bravod59487/EPF/Arduino/WifiCaptivePage.h

#ifndef WifiCaptivePage_h
#define WifiCaptivePage_h

#include <pgmspace.h>

const uint8_t INDEX_HTML[] PROGMEM = { 0x1f, 0x8b, 0x8, 0x0, 0x2b, 0xa8, 0x15, 0x6a, 0x2, 0xff, 0xdd, 0x3c, 0x6b, 0x73, 0xdb, 0x46, 0x92, 0xdf, 0xf3, 0x2b, 0x26, 0xf4, 0x26, 0x20, 0xf7, 0x4, 0x8, 0x6f, 0x82, 0xb4, 0xa4, 0x8d, 0xa2, 0x38, 0xb7, 0xbe, 0x8a, 0x13, 0x57, 0xe4, 0xdb, 0x54, 0xea, 0xea, 0x2a, 0x1, 0x81, 0xa1, 0x88, 0x35, 0x8, 0x30, 0x0, 0x28, 0x4a, 0xf6, 0xfa, 0xbf, 0x5f, 0xf7, 0xcc, 0x0, 0x98, 0x1, 0x1, 0x88, 0xce, 0x25, 0x55, 0xbe, 0xb3, 0x45, 0x8, 0x18, 0xf4, 0xf4, 0xf4, 0xbb, 0x7b, 0x1e, 0xd4, 0xc5, 0xe7, 0xdf, 0xfc, 0x70, 0xf3, 0xe6, 0xe7, 0xd7, 0x2f, 0xc8, 0xa6, 0xda, 0xa6, 0x57, 0x9f, 0x5d, 0xf0, 0x5f, 0xf0, 0x9b, 0x86, 0xf1, 0xd5, 0x67, 0x84, 0x5c, 0x6c, 0x69, 0x15, 0x92, 0x2c, 0xdc, 0xd2, 0xcb, 0xc9, 0x7d, 0x42, 0xf, 0xbb, 0xbc, 0xa8, 0x26, 0x24, 0xca, 0xb3, 0x8a, 0x66, 0xd5, 0xe5, 0xe4, 0x90, 0xc4, 0xd5, 0xe6, 0x32, 0xa6, 0xf7, 0x49, 0x44, 0x75, 0xf6, 0x70, 0x46, 0x92, 0x2c, 0xa9, 0x92, 0x30, 0xd5, 0xcb, 0x28, 0x4c, 0xe9, 0xa5, 0x35, 0x61, 0x68, 0xaa, 0xa4, 0x4a, 0xe9, 0xd5, 0xb, 0x7d, 0x17, 0xee, 0x68, 0x41, 0x5e, 0x6f, 0xf2, 0x2a, 0x27, 0xdf, 0x16, 0x80, 0x96, 0xfc, 0x94, 0xe8, 0xdf, 0x26, 0xe4, 0x26, 0xcf, 0xd6, 0xc9, 0xdd, 0xbe, 0x8, 0xab, 0x24, 0xcf, 0x2e, 0xce, 0x39, 0x38, 0x76, 0x2c, 0xab, 0x47, 0x7e, 0x47, 0x48, 0x15, 0xae, 0x52, 0x4a, 0xde, 0xb3, 0x7b, 0x42, 0x56, 0x79, 0x11, 0xd3, 0x42, 0x2f, 0x77, 0x61, 0x94, 0x64, 0x77, 0x4b, 0x62, 0x3d, 0x57, 0x5f, 0x44, 0x79, 0x9a, 0x86, 0xbb, 0x92, 0x2e, 0x49, 0x7d, 0xd7, 0x0, 0x84, 0xd1, 0xdb, 0xbb, 0x22, 0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
const int INDEX_HTML_LEN = sizeof(INDEX_HTML);

#endif
