bravod59487/EPF/(commit log)

2026-08-13 Reset button: restore the server's defaults instead of its own
    confirmReset() carried a hardcoded copy of the default values, and most
    of them had drifted from DEFAULT_CONFIG in app.py:
    url http://localhost -> http://192.168.1.10
    rotation 0 -> 270
    display_mode fit -> fill
    enhanced 1.0 -> 1.3
    contrast 1.0 -> 0.9
    wakeup_interval 30 -> 60
    "Reset to Default" therefore produced a configuration the server would
    never have chosen, and saving it wrote those values to config.yaml.
    Render DEFAULT_CONFIG['immich'] into the page and drive the reset from
    it, so th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
2026-08-13 Stop the settings error page from raising UndefinedError
    Both error returns in settings() omitted battery_voltage and
    battery_percentage, but the template formats battery_percentage with
    "%.1f". Jinja raises UndefinedError on that, so the page meant to report
    "Error saving configuration: ..." returned a 500 instead and the user
    never saw the reason.
    Pass the values through; both are already computed at the top of
    settings(), so the error page now also keeps showing the battery reading
    instead of dropping it. Default battery_percentage to 0 in the template
    as well, so a future caller that forgets it degrades to an empty gauge
    rather than a 500.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
2026-08-13 Add docker-compose.yml so runtime data survives an image update
    /config/config.yaml and /photos/tracking.txt are the only state the
    server keeps, and neither README command mounted them. A plain restart
    keeps them, but recreating the container - which is exactly what pulling
    a new image requires - discards the container filesystem, so every
    setting saved from the web page reverts to DEFAULT_CONFIG and the
    shown-photo history is lost. Nothing errors: the frame just quietly goes
    back to pointing at 192.168.1.10.
    The compose file bind-mounts both directories, and additionally:
    - refuses to start when IMMICH_API_KEY is unset, rather than booting with
    no key and having every Immich request co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
2026-08-14 Add a favicon and stop the footer year going stale
    The footer had 2025 hardcoded, so it would have to be edited every
    January. A context processor injects current_year instead, which covers
    every render path including the two error pages.
    The favicon is served from static/, which Flask registers automatically,
    so no new route is needed. The source artwork is 882x882 and 1.3 MB, far
    too heavy to load on every page view, so it ships downscaled: 32x32
    (2.0 kB) for the browser tab and 180x180 (50 kB) for an iOS home-screen
    shortcut.
2026-08-14 Restyle the settings page around the panel's own palette
    The page used a stock indigo-on-grey theme that had nothing to do with
    the product. It now takes its colours from the frame itself: charcoal
    bezel, warm paper white, and the muted slate, moss and mustard the
    Spectra 6 palette actually renders, with the app icon as the header mark.
    Also in this pass:
    - a dark theme via prefers-color-scheme, and a reduced-motion guard
    - every colour is a custom property, so re-theming means editing one
    block rather than hunting through rules
    - the battery meter is colour-coded by level instead of always red, and
    0% now reads as "waiting for the frame to check in" rather than looking
    like a flat b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
2026-08-14 Show the photo the frame is currently displaying
    The settings page had no way to tell what the frame is actually showing;
    the only hint was the X-Photo-Url header the firmware does not read yet.
    A "now showing" card is added at the top of the page, holding the image
    the panel is displaying, a toggle between that and the Immich original,
    and the time it was sent. Clicking the image opens the asset in the
    configured Immich server, so the link works on the LAN rather than
    routing through my.immich.app the way the NFC header does.
    /download now keeps the dithered result in memory alongside the asset id,
    so /preview shows the quantised, cropped, rotated image that is really on
    the panel rather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
2026-08-14 Add a theme switch instead of only following the OS
    Dark mode was driven purely by prefers-color-scheme, so there was no way
    to pick a theme that differs from the system setting. A button in the
    header now cycles through follow-system, light and dark, remembered in
    localStorage next to the language choice.
    The mode is resolved to an explicit data-theme attribute on <html> rather
    than being expressed as a media query, which means the dark palette lives
    in exactly one block instead of being duplicated between the automatic
    and manual cases where the two copies could drift apart.
    An inline script in <head> applies the stored choice before the
    stylesheet is evaluated, so a saved theme never fl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
2026-08-14 Use the full width on desktop instead of one narrow column
    Everything sat in a single 780px column, so on a laptop or desktop most
    of the window was empty margin while the form itself stayed cramped.
    From 960px the page is now two columns: the photo preview and battery
    become a sidebar, and the settings form takes the rest. The sidebar is
    sticky, so what the frame is showing and how much charge is left stay
    visible while the form is scrolled and adjusted. Below 960px the grid
    collapses back to the single column, so phones are unchanged.
    Most of this diff is the indentation shift from wrapping the two status
    cards and the form in the new grid container.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
2026-08-14 Add a /status endpoint for live Immich and frame health
    The settings page could not tell you whether anything was actually
    working: a wrong API key, a renamed album or a frame that had stopped
    waking up all looked identical to a correctly configured server.
    /status answers all three from one place. Immich is probed with the same
    GET /api/albums call /download makes first, which in a single request
    distinguishes unreachable, key rejected, album missing and healthy - the
    kind of check that would have caught the README's IMMICH-API-KEY typo
    immediately. The frame is judged by when it last checked in, taken from
    the battery header or the last photo sent, and counted stale after two of
    its own w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
2026-08-14 Move status into the header and the preview to the top
    Reworks the page around what you look at versus what you change:
    - the header gains a status strip: an Immich indicator, a frame indicator
    showing how long ago it checked in, and the battery as a compact chip
    whose fill and colour track the level. Battery reads as a dash rather
    than 0% before the frame has ever reported in.
    - the "now showing" preview moves out of the sidebar to a full-width band
    directly under the header, image beside album name, timestamp and the
    frame/original toggle. It is still omitted entirely when no photo has
    been sent yet.
    - the settings cards below pair into two columns from 900px and collapse
    to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
2026-08-14 Centre the form buttons on desktop
    The button row spans both columns, so left-aligning left it hanging off
    the edge of an otherwise full-width row. Phones are unaffected: the
    buttons are already stacked full width there.
2026-08-14 Add a system log of frame check-ins and server changes
    There was no way to answer "why did the frame not update" or "when did
    this setting change". Events are now appended as JSONL next to
    tracking.txt, so the mount that already keeps the settings keeps the
    history, and shown in a card at the foot of the settings page.
    Recorded: each check-in with the client IP, battery in mV and percent,
    which photo was sent and from which album; the sleep window handed back;
    settings saves with a before/after diff of only the fields that moved;
    external edits to config.yaml; photo-history resets and why; download
    failures with the reason; and server start.
    MAC address and signal strength cannot be obtain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
2026-08-14 Choose the next photo in advance and preview the originals
    Reworks the preview around three requests: show the Immich original rather
    than the dithered panel image, show what is coming next, and offer to swap
    it.
    Album fetching and asset selection move out of /download into
    resolve_album_id(), list_album_assets() and select_asset(), so the choice
    can be made ahead of time. /next picks and remembers the next asset, and
    /download hands over exactly that one, so the page and the frame cannot
    disagree. POST /next picks a different one, which is what the swap button
    uses. Under "random" ordering there was previously no such thing as the
    next photo: it did not exist until the device asked.
    The d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
2026-08-14 Show the current and next photo in one card
    Two full-width cards, one under the other, took up most of the first
    screen for what is really one thing: which photo is on the frame and which
    one follows. They are now a single "Photos" card holding two captioned
    slots side by side, stacking on phones, with the swap button on the card
    heading.
    The card is hidden until there is something in it. It renders hidden when
    the frame has not been sent a photo yet, and reveals itself once a next
    photo has been chosen, so a fresh restart shows the upcoming photo rather
    than an empty block.
2026-08-14 Warn over Telegram or LINE when the battery runs low
    The frame reports its voltage on every wake-up but nothing acted on it, so
    a flat battery was only visible if you happened to open the settings page.
    A notify section on the settings page turns warnings on, picks the service,
    and sets the level to warn at and the shortest gap between messages. The
    gap matters: the frame checks in every wake-up interval, so without it a
    low battery would message all day.
    Credentials come from the environment rather than config.yaml, the same as
    IMMICH_API_KEY, because the settings page has no authentication and
    anything in the config is readable by anyone who can open the page.
    docker-compose.yml passes t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
2026-08-14 Let each linked service be ticked on or off
    Linking both Telegram and LINE meant both were messaged, with no way to
    keep one linked but quiet. Linked and used are now separate: a tick box
    under each service decides who actually receives warnings, while linking
    only establishes that the credentials work.
    The boxes default to on, so linking a service is still enough on its own,
    and they are disabled while a service is unlinked - there is nowhere to
    send to. The standalone test now sends exactly where a real warning would
    go, rather than to everything linked, so it cannot report success for a
    service that has been ticked off.
    Two fixes found while testing:
    - the reset button skipped the boxe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
2026-10-03 Firmware: NFC tag writing, PlatformIO build, BUSY timeout, portal fixes
    Arduino/
    - Add NfcWriter (ST25DV over I2C on GPIO 19/20, powered from GPIO 4).
    On boot the tag gets an "Updating..." placeholder; after /download the
    X-Photo-Url response header is written as an NDEF URI. Power is cut and
    the GPIO held LOW through deep sleep.
    - Add platformio.ini (pioarduino platform for ESP32-C6, min_spiffs
    partitions, ESP32Async AsyncTCP/ESPAsyncWebServer, ArduinoJson 7, ST25DV).
    - EPD_7IN3E_BusyHigh(): 60 s timeout instead of blocking forever when the
    panel is missing or faulty; BUSY pin uses INPUT_PULLUP.
    - Serial.begin() moved to the top of setup() with a bounded wait for the
    USB CDC hos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
    [WifiCaptive.cpp, WifiCaptive.h, WifiCaptivePage.h, config.h, epd7in3e.cpp, epd7in3e.ino]
2026-10-03 Ignore PlatformIO build output and generated .vscode under Arduino/
    Also add the .gitignore PlatformIO generates in Arduino/ on project init.
2026-10-03 Rename Arduino/scratch to Arduino/AP_webpage_src
    The folder holds the captive-portal HTML source and the scripts that
    regenerate WifiCaptivePage.h, not scratch files. Update the PlatformIO
    src filter and docs accordingly; ignore transient *.ino.cpp files.
2026-10-03 Rewrite README for the current architecture
    Describe the server/firmware split, the wake cycle, the settings page,
    notifications and NFC as they exist today. Document the environment
    variables, what is persisted where, the HTTP contract, PlatformIO and
    Arduino IDE builds, wiring and the captive-portal setup. Drop the WIP
    banner and the obsolete config.yaml section.
    Also fix the comment on X-Photo-Url in app.py: the firmware reads it now.
2026-10-03 Status screens, failure back-off, faster wake-ups and server pre-rendering (#13)
    * Firmware: bounded retries and short sleep on failure; server: Immich timeouts
    The 500 branch of downloadImage() re-armed the outer retry loop every time,
    so a server that kept answering 500 kept the frame awake indefinitely. Any
    other failure, including not reaching the server at all, slept 24 hours.
    Firmware:
    - A 500 (or 202) is retried at most MAX_RETRIES times, RETRY_DELAY apart.
    - A failed download sleeps MIN_SLEEP_TIME (15 min) instead of 24 hours.
    - A successful download whose /sleep call fails sleeps SLEEP_INTERVAL (1 h).
    - hibernate() defaults to SLEEP_INTERVAL; the unreachable branch is gone.
    The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
    [WifiCaptive.cpp, config.h, epd7in3e.ino]
2026-10-03 Firmware: keep USB serial writes from stalling the wake-up (#14)
    With the frame plugged into a PC that has no terminal open, the host's
    USB driver reads the device's output only until its own buffer is full,
    then stops. HWCDC::write() treats that as back-pressure and waits up to
    20 x tx_timeout_ms (2 s) for room on every print, so the twenty-odd lines
    of a wake-up added almost a minute: measured 92.4 s awake without a
    terminal against 36.8 s with one reading. On battery, or with a monitor
    attached, the wait never triggers, which is why it only showed up on the
    bench.
    Serial.setTxTimeoutMs(2) caps the wait at 20 x 2 ms per write. A terminal
    that is reading drains the ring buffer far faster t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
    [epd7in3e.ino]
2026-10-04 Wake-up telemetry in the check-in, no serial wait on battery, /next race fix (#15)
    On battery there is no serial port, so where a wake-up spends its time
    before the request could not be seen. The firmware now sends X-Uptime-Ms
    (milliseconds awake when it asks) and X-Wake (manual or timer) with
    /download; the server records them in the check-in event (uptime_ms,
    wake) and the settings page shows "awake N s before request". Together
    with the /download-to-/sleep gap this covers the whole wake-up.
    setup() skips the serial-monitor wait altogether when Serial.isPlugged()
    is false: on battery no host can ever attach, so the 2 s were pure waste.
    /next raced the preparation thread at start-up: both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
    [epd7in3e.ino]
2026-10-04 Web installer on GitHub Pages and a Traditional Chinese README (#16)
    docs/ is a static page around two ESP Web Tools install buttons, served by
    GitHub Pages at https://jwchen119.github.io/EPF/. It lets anyone with
    Chrome or Edge flash a released firmware without installing anything:
    "Update" writes the application only (0x10000) and keeps the Wi-Fi and
    server settings, "Full install" writes the combined image from 0x0 for a
    new board. ESP Web Tools erases the whole flash for boards without Improv
    unless the manifest asks first, so update.json sets
    new_install_prompt_erase and the page tells the user to leave the box
    unticked. The page is in Traditional Chinese and English (toggle, ?lang=,
    re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
2026-10-04 Web installer on GitHub Pages and a Traditional Chinese README (#17)
    * Web installer on GitHub Pages and a Traditional Chinese README
    unticked.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
2026-10-04 Firmware 1.2.0: identify to the web installer over Improv Serial (#18)
    ESP Web Tools asks a freshly connected device who it is over Improv
    Serial. Without an answer it treats every install as a new one, which
    means an "Erase device" question and no indication of what is running.
    The frame now answers with its firmware name, version and chip, so the
    installer shows the current version and offers "Update", which writes the
    application without erasing the flash and keeps the settings in NVS.
    Only the identification part of Improv is implemented
    (Arduino/improv_serial.*): current state and device info. Wi-Fi
    provisioning was tried and taken out again, since the frame is set up
    through its own c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
2026-10-04 Download: skip videos, decode more RAW files, fall back to the preview (#19)
    /download failed with "cannot identify image file <_io.BytesIO>", which
    named neither the cause nor the photo. Videos in the album reached PIL
    (188 of the 17,600 assets in the test album, about one wake-up in 90),
    RAW files from cameras outside a five-extension list were not decoded,
    and a trickling download of a large original could outlast the frame.
    - Ask Immich for images only (type: IMAGE), and filter again for servers
    that ignore it
    - Recognise more RAW extensions, and try rawpy on anything PIL cannot
    identify; otherwise fail with the file's name
    - Decode the original fully in open_asset(), so a truncated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
